Donderstraal/Lattepanda-MU-Nano-ITX-carrier-board/Board.pdf

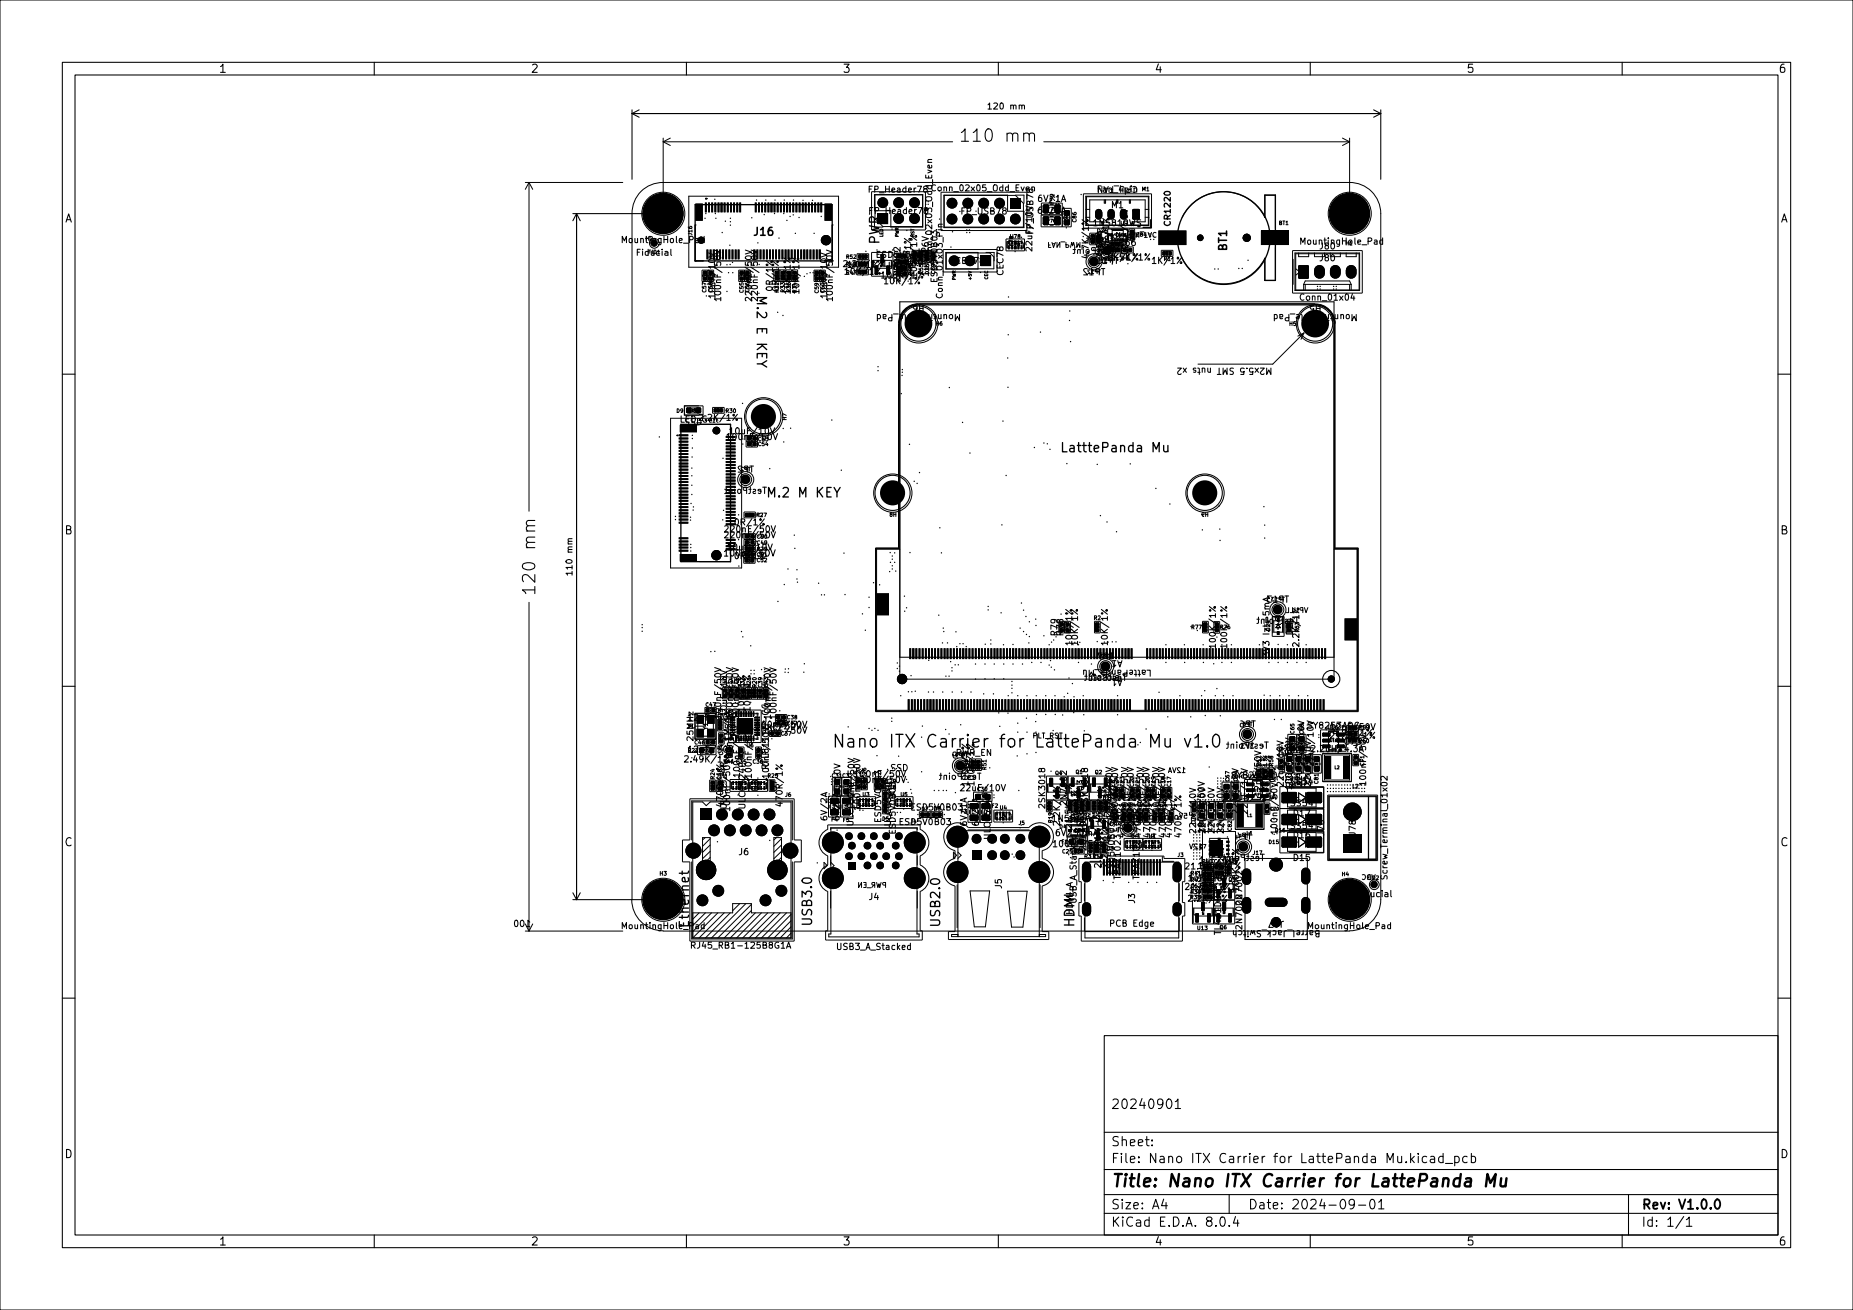
[picture p12: page 1]
