Donderstraal/Lattepanda-MU-Nano-ITX-carrier-board/Nano ITX Carrier for LattePanda Mu.kicad_sch

## KiCad design Nano ITX Carrier for LattePanda Mu.kicad_sch (2024-09-01)

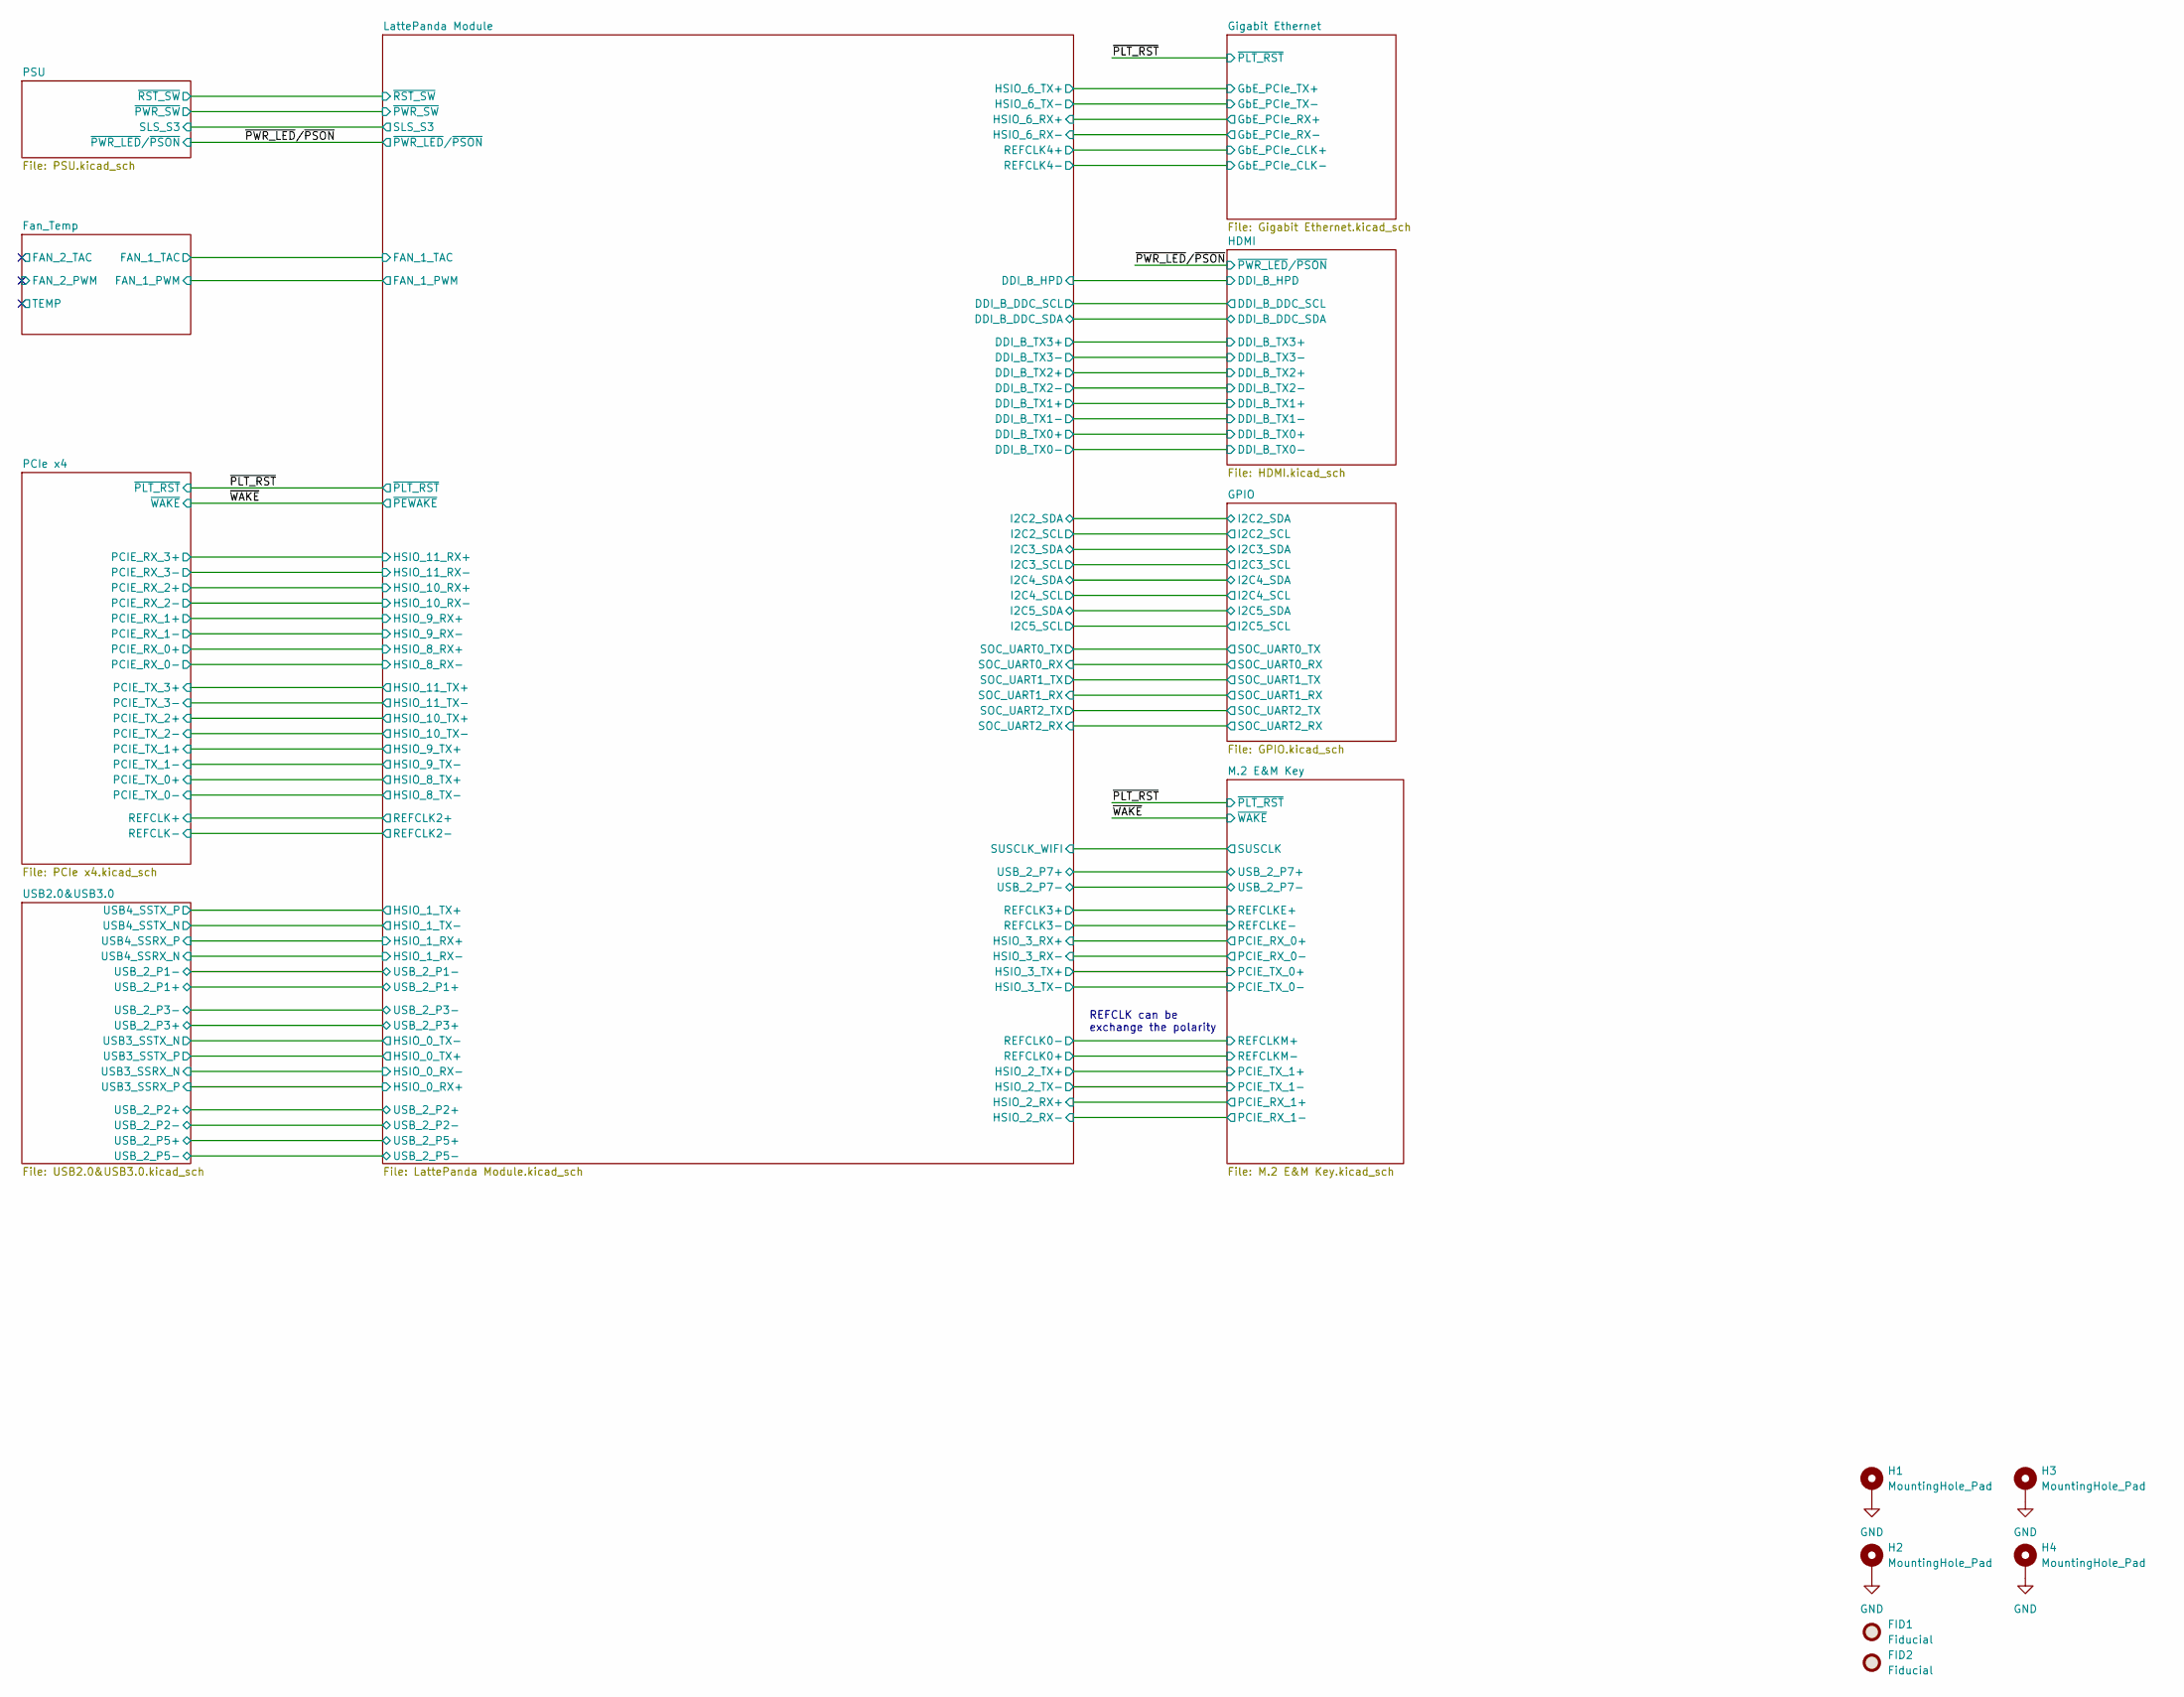
[picture p20: schematic Nano ITX Carrier for LattePanda Mu.kicad_sch]

Parts:
FID1, FID2: Fiducial; Fiducial_0.5mm_Mask1mm
H1, H2, H3, H4: MountingHole_Pad; MountingHole_3.2mm_M3_Pad_Via

Connections:
GND: H1.1, H2.1, H3.1, H4.1

Notes on the sheet:
REFCLK can be exchange the polarity
