Donderstraal/Lattepanda-MU-Nano-ITX-carrier-board/PCIe x4.kicad_sch

## KiCad design PCIe x4.kicad_sch (2024-09-01)

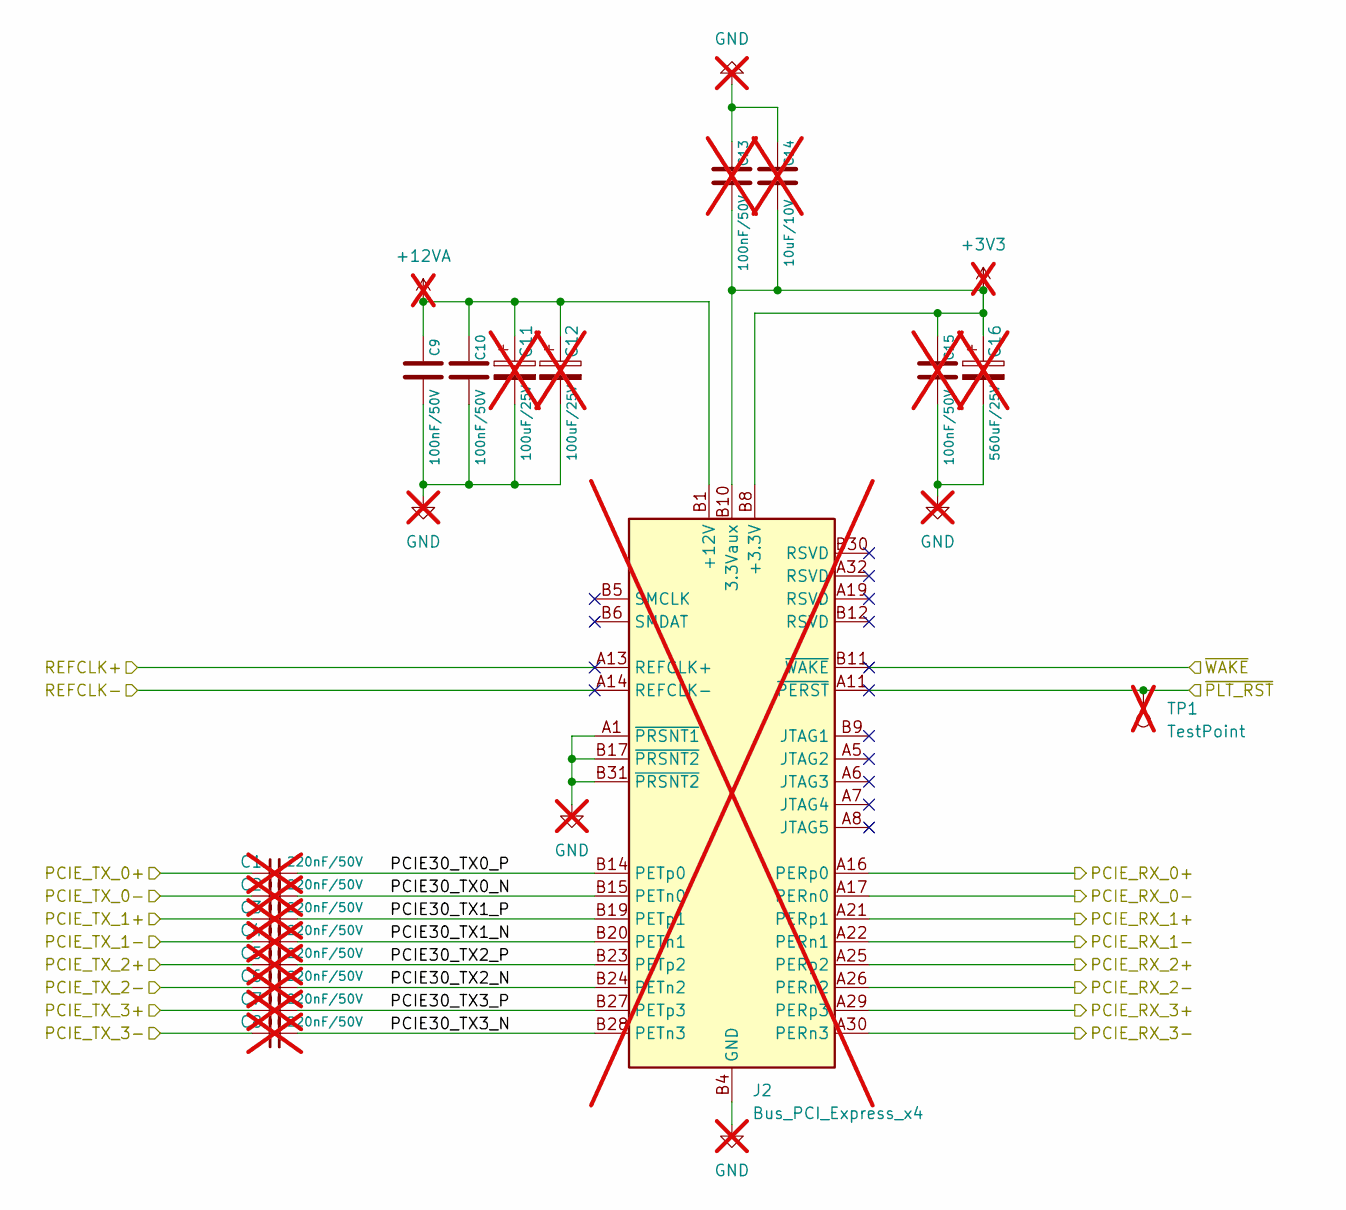
[picture p21: schematic PCIe x4.kicad_sch]

Parts:
C1, C2, C3, C4, C5, C6, C7, C8: 220nF/50V; C_0402_1005Metric; not fitted
C9, C10: 100nF/50V; C_0402_1005Metric
C11, C12: 100uF/25V; CP_Elec_6.3x7.7; not fitted
C13, C15: 100nF/50V; C_0402_1005Metric; not fitted
C14: 10uF/10V; C_0402_1005Metric; not fitted
C16: 560uF/25V; CP_Elec_6.3x7.7; not fitted
J2: Bus_PCI_Express_x4; PCIe_x4_Gen3Slot_Connectors; not fitted
TP1: TestPoint; TestPoint_Pad_D1.5mm; not fitted

Connections:
+3V3: C13.2, C14.2, C15.1, C16.1, J2.A9 (+3.3V), J2.A10 (+3.3V), J2.B8 (+3.3V), J2.B10 (3.3Vaux)
+12VA: C9.1, C10.1, C11.1, C12.1, J2.A2 (+12V), J2.A3 (+12V), J2.B1 (+12V), J2.B2 (+12V), J2.B3 (+12V)
GND: C9.2, C10.2, C11.2, C12.2, C13.1, C14.1, C15.2, C16.2, J2.A1 (~PRSNT1), J2.A4 (GND), J2.A12 (GND), J2.A15 (GND), J2.A18 (GND), J2.A20 (GND), J2.A23 (GND), J2.A24 (GND), J2.A27 (GND), J2.A28 (GND), J2.A31 (GND), J2.B4 (GND), J2.B7 (GND), J2.B13 (GND), J2.B16 (GND), J2.B17 (~PRSNT2), J2.B18 (GND), J2.B21 (GND), J2.B22 (GND), J2.B25 (GND), J2.B26 (GND), J2.B29 (GND), J2.B31 (~PRSNT2), J2.B32 (GND)
PCIE30_TX0_N: C2.2, J2.B15 (PETn0)
PCIE30_TX0_P: C1.2, J2.B14 (PETp0)
PCIE30_TX1_N: C4.2, J2.B20 (PETn1)
PCIE30_TX1_P: C3.2, J2.B19 (PETp1)
PCIE30_TX2_N: C6.2, J2.B24 (PETn2)
PCIE30_TX2_P: C5.2, J2.B23 (PETp2)
PCIE30_TX3_N: C8.2, J2.B28 (PETn3)
PCIE30_TX3_P: C7.2, J2.B27 (PETp3)
PCIE_RX_0+: J2.A16 (PERp0)
PCIE_RX_0-: J2.A17 (PERn0)
PCIE_RX_1+: J2.A21 (PERp1)
PCIE_RX_1-: J2.A22 (PERn1)
PCIE_RX_2+: J2.A25 (PERp2)
PCIE_RX_2-: J2.A26 (PERn2)
PCIE_RX_3+: J2.A29 (PERp3)
PCIE_RX_3-: J2.A30 (PERn3)
PCIE_TX_0+: C1.1
PCIE_TX_0-: C2.1
PCIE_TX_1+: C3.1
PCIE_TX_1-: C4.1
PCIE_TX_2+: C5.1
PCIE_TX_2-: C6.1
PCIE_TX_3+: C7.1
PCIE_TX_3-: C8.1
REFCLK+: J2.A13 (REFCLK+)
REFCLK-: J2.A14 (REFCLK-)
~PLT_RST: J2.A11 (~PERST), TP1.1
~WAKE: J2.B11 (~WAKE)
