Donderstraal/Lattepanda-MU-Nano-ITX-carrier-board/USB2.0&USB3.0.kicad_sch

## KiCad design USB2.0&USB3.0.kicad_sch (2024-09-01)

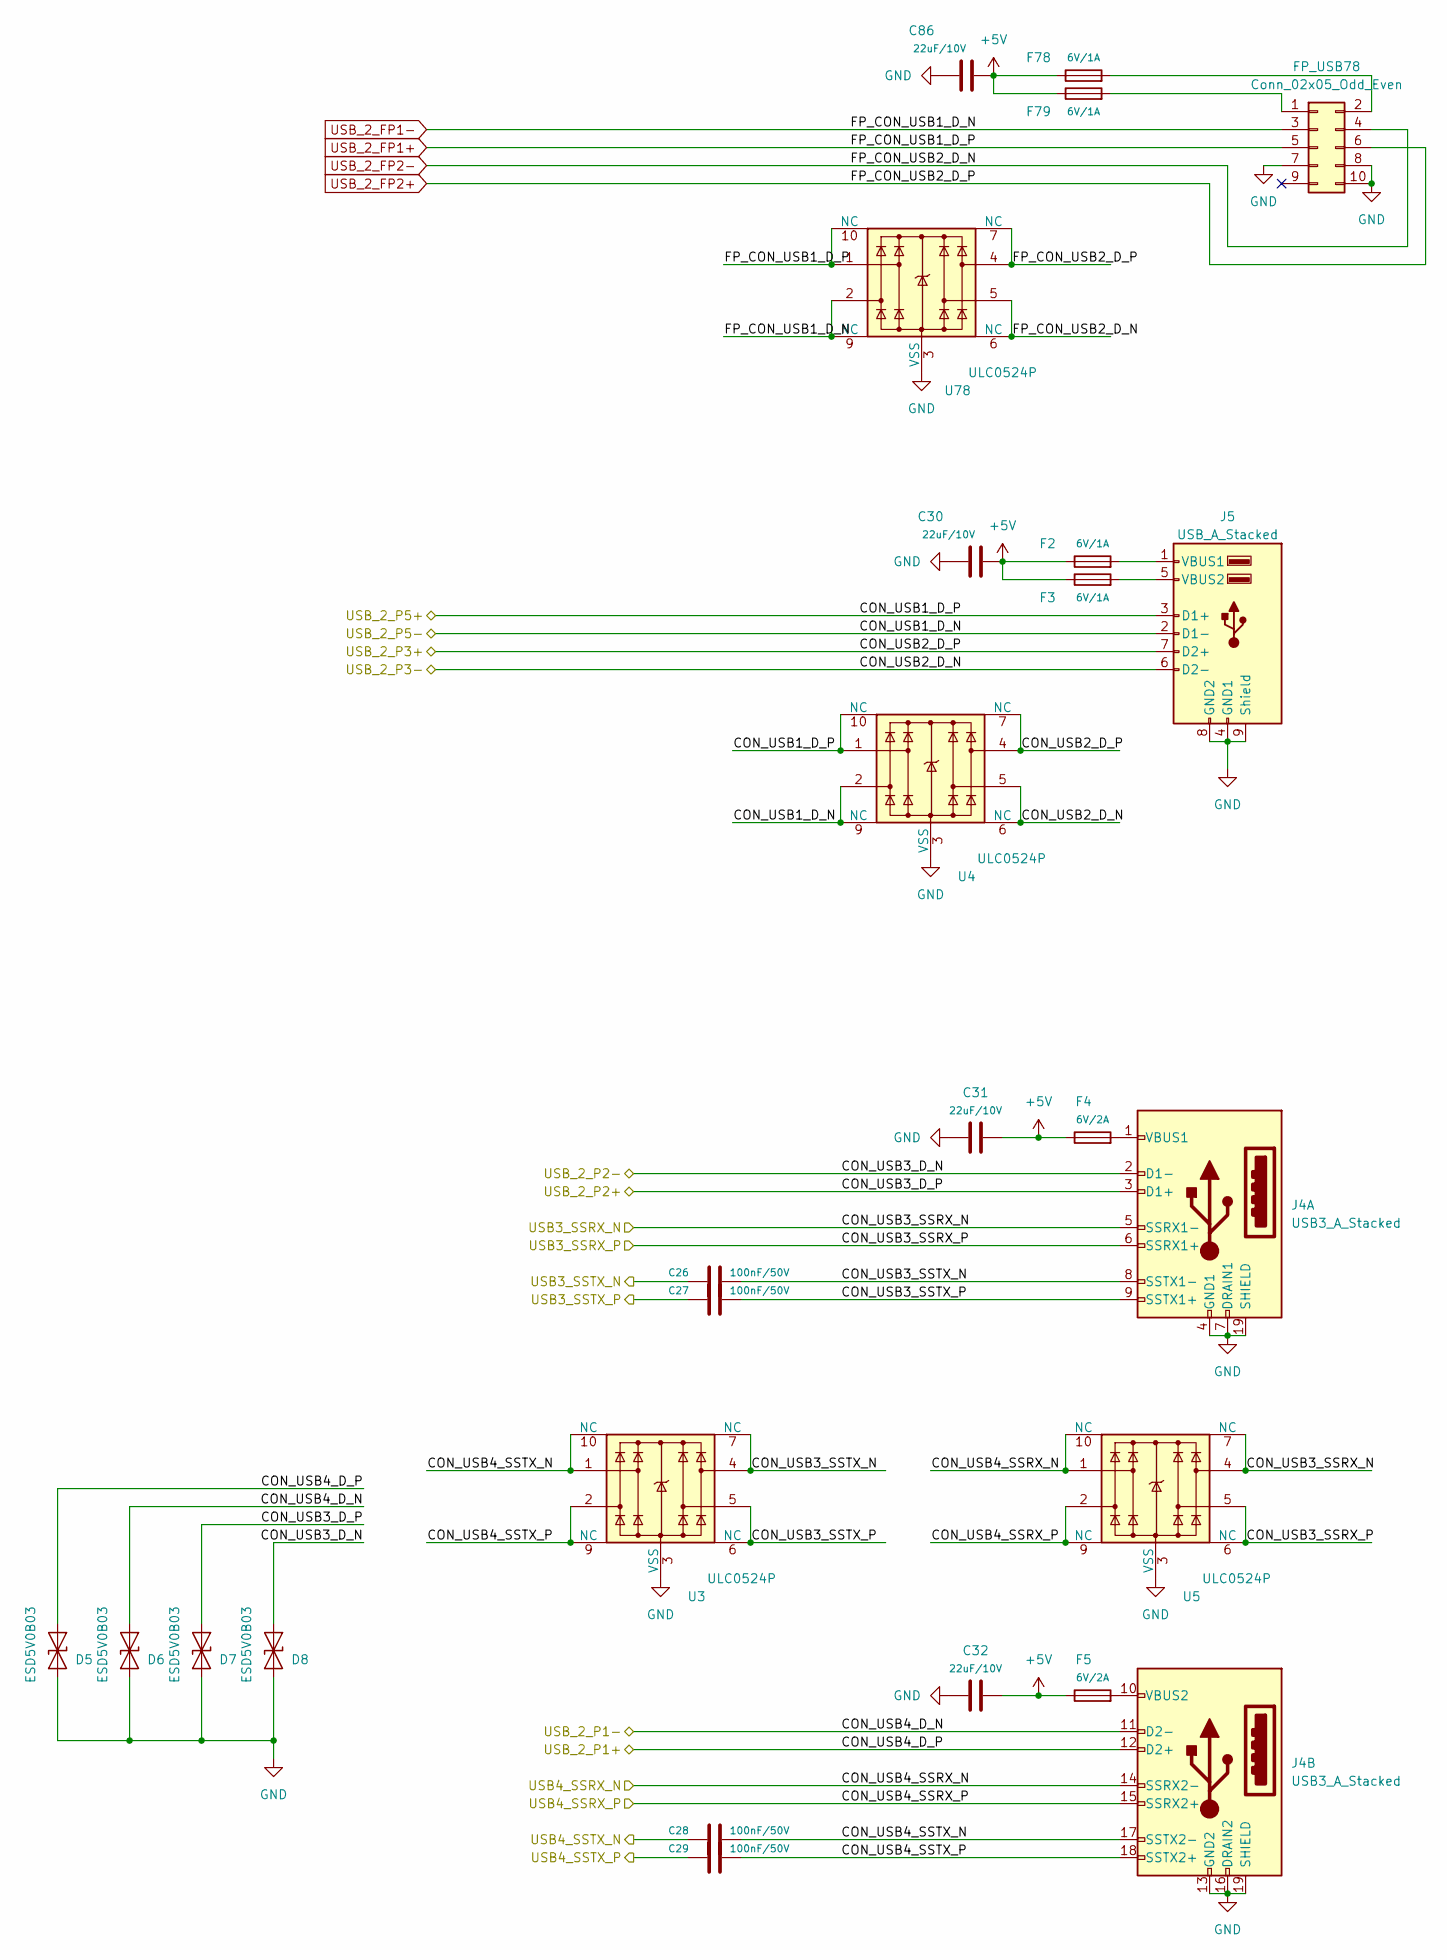
[picture p23: schematic USB2.0&USB3.0.kicad_sch]

Parts:
C26, C27, C28, C29: 100nF/50V; C_0402_1005Metric
C30, C31, C32, C86: 22uF/10V; C_0603_1608Metric
D5, D6, D7, D8: ESD5V0B03; D_0402_1005Metric
F2, F3, F78, F79: 6V/1A; Fuse_0805_2012Metric
F4: 6V/2A; R_0805_2012Metric
F5: 6V/2A; Fuse_0805_2012Metric
FP_USB78: Conn_02x05_Odd_Even; PinHeader_2x05_P2.54mm_Vertical
J4: USB3_A_Stacked; USB3_A_Molex_48406-0001_Horizontal_Stacked
J5: USB_A_Stacked; USB_A_CUI_UJ2-ADH-TH_Horizontal_Stacked
U3, U4, U5, U78: ULC0524P; Diodes_UDFN-10_1.0x2.5mm_P0.5mm

Connections:
+5V: C30.2, C31.2, C32.2, C86.2, F2.1, F3.1, F4.1, F5.1, F78.1, F79.1
CON_USB1_D_N: J5.2 (D1-), U4.2, U4.9 (NC)
CON_USB1_D_P: J5.3 (D1+), U4.1, U4.10 (NC)
CON_USB2_D_N: J5.6 (D2-), U4.5, U4.6 (NC)
CON_USB2_D_P: J5.7 (D2+), U4.4, U4.7 (NC)
CON_USB3_D_N: D8.2 (A2), J4.2 (D1-)
CON_USB3_D_P: D7.2 (A2), J4.3 (D1+)
CON_USB3_SSRX_N: J4.5 (SSRX1-), U5.4, U5.7 (NC)
CON_USB3_SSRX_P: J4.6 (SSRX1+), U5.5, U5.6 (NC)
CON_USB3_SSTX_N: C26.2, J4.8 (SSTX1-), U3.4, U3.7 (NC)
CON_USB3_SSTX_P: C27.2, J4.9 (SSTX1+), U3.5, U3.6 (NC)
CON_USB4_D_N: D6.2 (A2), J4.11 (D2-)
CON_USB4_D_P: D5.2 (A2), J4.12 (D2+)
CON_USB4_SSRX_N: J4.14 (SSRX2-), U5.1, U5.10 (NC)
CON_USB4_SSRX_P: J4.15 (SSRX2+), U5.2, U5.9 (NC)
CON_USB4_SSTX_N: C28.2, J4.17 (SSTX2-), U3.1, U3.10 (NC)
CON_USB4_SSTX_P: C29.2, J4.18 (SSTX2+), U3.2, U3.9 (NC)
GND: C30.1, C31.1, C32.1, C86.1, D5.1 (A1), D6.1 (A1), D7.1 (A1), D8.1 (A1), FP_USB78.7, FP_USB78.8, FP_USB78.10, J4.4 (GND1), J4.7 (DRAIN1), J4.13 (GND2), J4.16 (DRAIN2), J4.19 (SHIELD), J5.4 (GND1), J5.8 (GND2), J5.9 (Shield), U3.3 (VSS), U3.8 (VSS), U4.3 (VSS), U4.8 (VSS), U5.3 (VSS), U5.8 (VSS), U78.3 (VSS), U78.8 (VSS)
unnamed: F2.2, J5.1 (VBUS1)
unnamed: F3.2, J5.5 (VBUS2)
unnamed: F4.2, J4.1 (VBUS1)
unnamed: F5.2, J4.10 (VBUS2)
unnamed: F78.2, FP_USB78.2
unnamed: F79.2, FP_USB78.1
USB3_SSTX_N: C26.1
USB3_SSTX_P: C27.1
USB4_SSTX_N: C28.1
USB4_SSTX_P: C29.1
USB_2_FP1+: FP_USB78.5, U78.1, U78.10 (NC)
USB_2_FP1-: FP_USB78.3, U78.2, U78.9 (NC)
USB_2_FP2+: FP_USB78.6, U78.4, U78.7 (NC)
USB_2_FP2-: FP_USB78.4, U78.5, U78.6 (NC)
